TMO2018/1541-Diskettenlocher/Rev1_0/pic/1.jpg

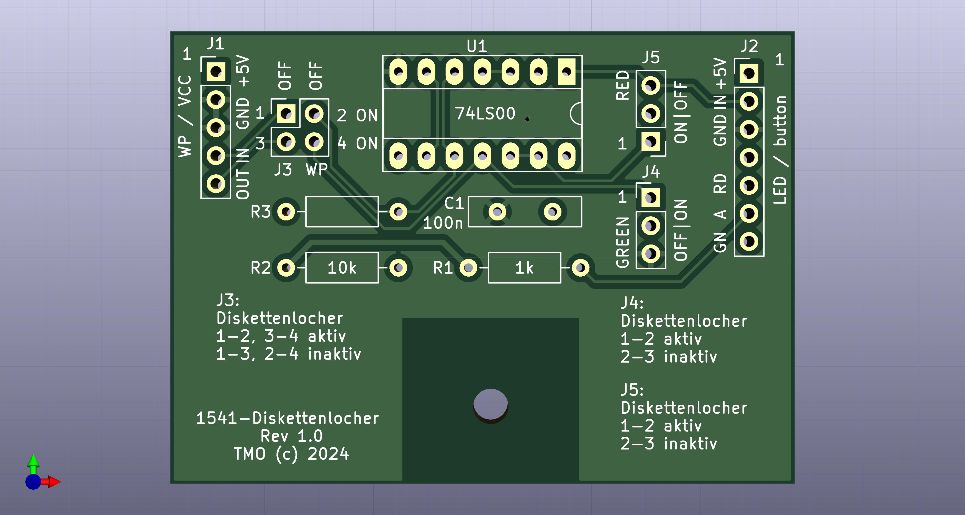
Rev1_0/pic/1.jpg
