TMO2018/1541-Diskettenlocher/Rev1_0/pic/IMG_0627.JPG

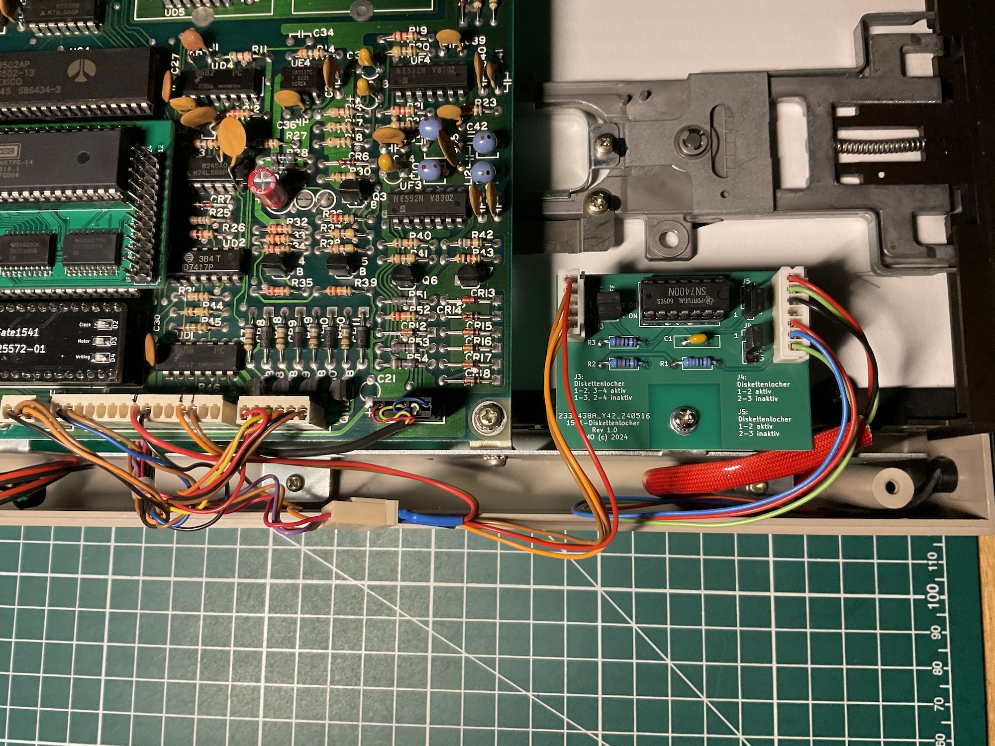
Rev1_0/pic/IMG_0627.JPG
