TMO2018/1541-Diskettenlocher/README.md

# 1541-Diskettenlocher
Elektronischer Diskettenlocher mit Touch-Sensor TTP223 für das Commodore-Diskettenlaufwerk VIC-1541
