TMO2018/1541-Diskettenlocher/Rev1_0/doc/DUO LED 5mm BiColor rot  grün diffus 3Pin gemeinsame Anode.pdf

Von: mail@tmonet.de
Betreff: DUO LED 5mm Bi-Color rot / grün diffus 3-Pin gemeinsame Anode Datum: 16. Mai 2024 um 15:38
An: Walter Thomas info.tom@t-online.de

Technische Daten:

Bauform: 5mm
Leuchtfarbe: rot und grün
Spannung: rot 2V DC / grün 3V DC Strom: 20mA
Abstrahlwinkel: 140°
Gehäusefarbe: weiß diffus

Gemeinsame Anode heißt: der mittlere längere Pin ist für + und die beiden äußeren sind -
