TMO2018/1541-Diskettenlocher/Rev1_0/pic/2.jpg

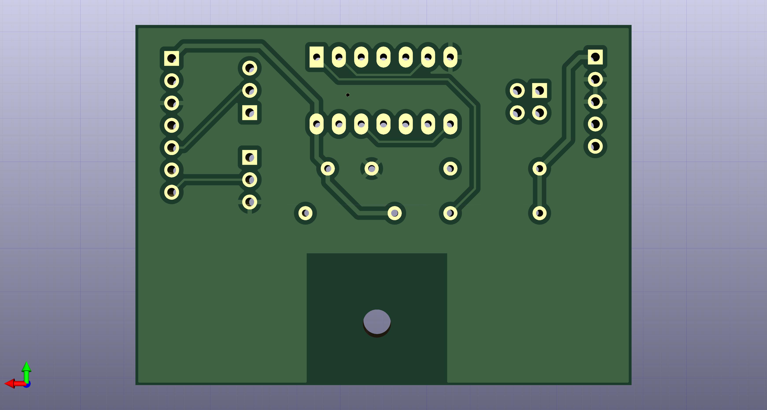
Rev1_0/pic/2.jpg
