TMO2018/1541-Diskettenlocher/Rev1_0/doc/1541_Diskettenlocher_schematic.pdf

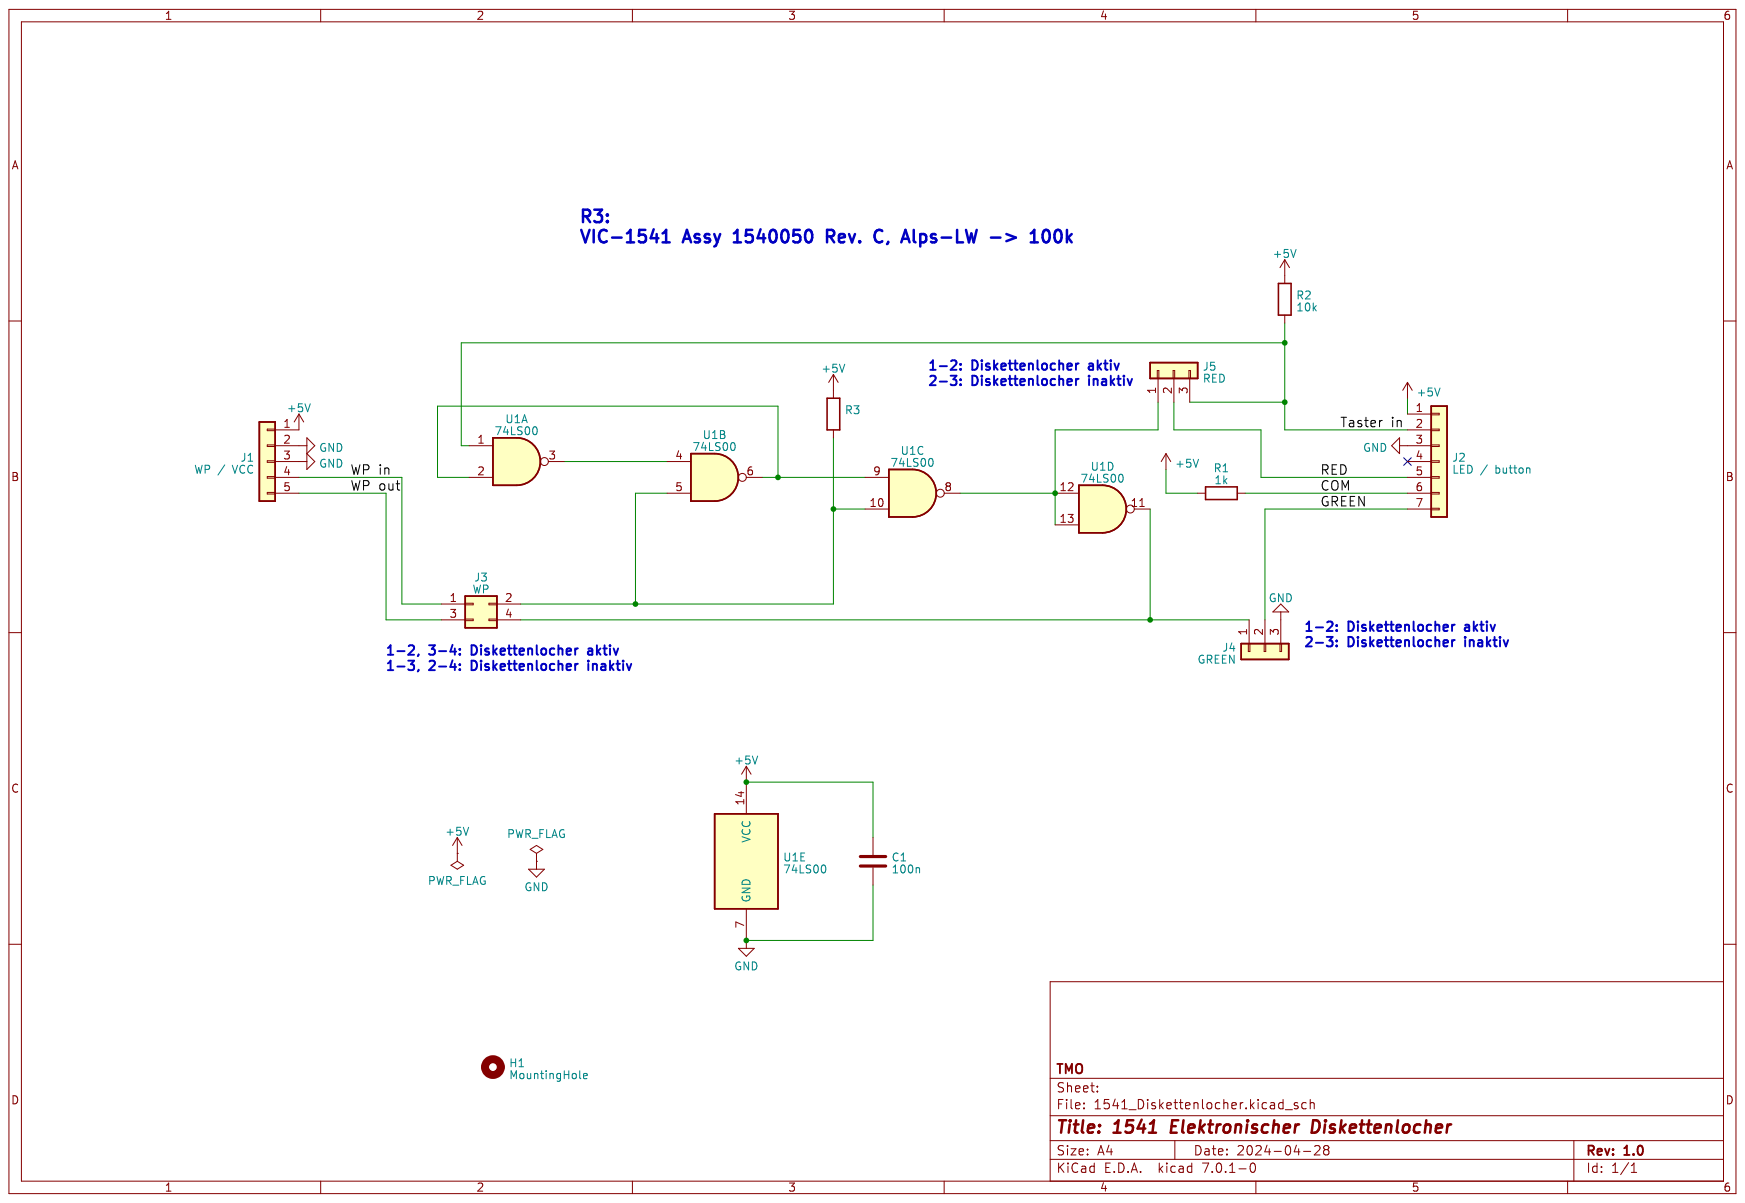
[picture p12: page 1]
