TMO2018/1541-Diskettenlocher/Rev1_0/1541_Diskettenlocher.kicad_pcb

## KiCad design Rev1_0/1541_Diskettenlocher.kicad_pcb (2024-06-19)

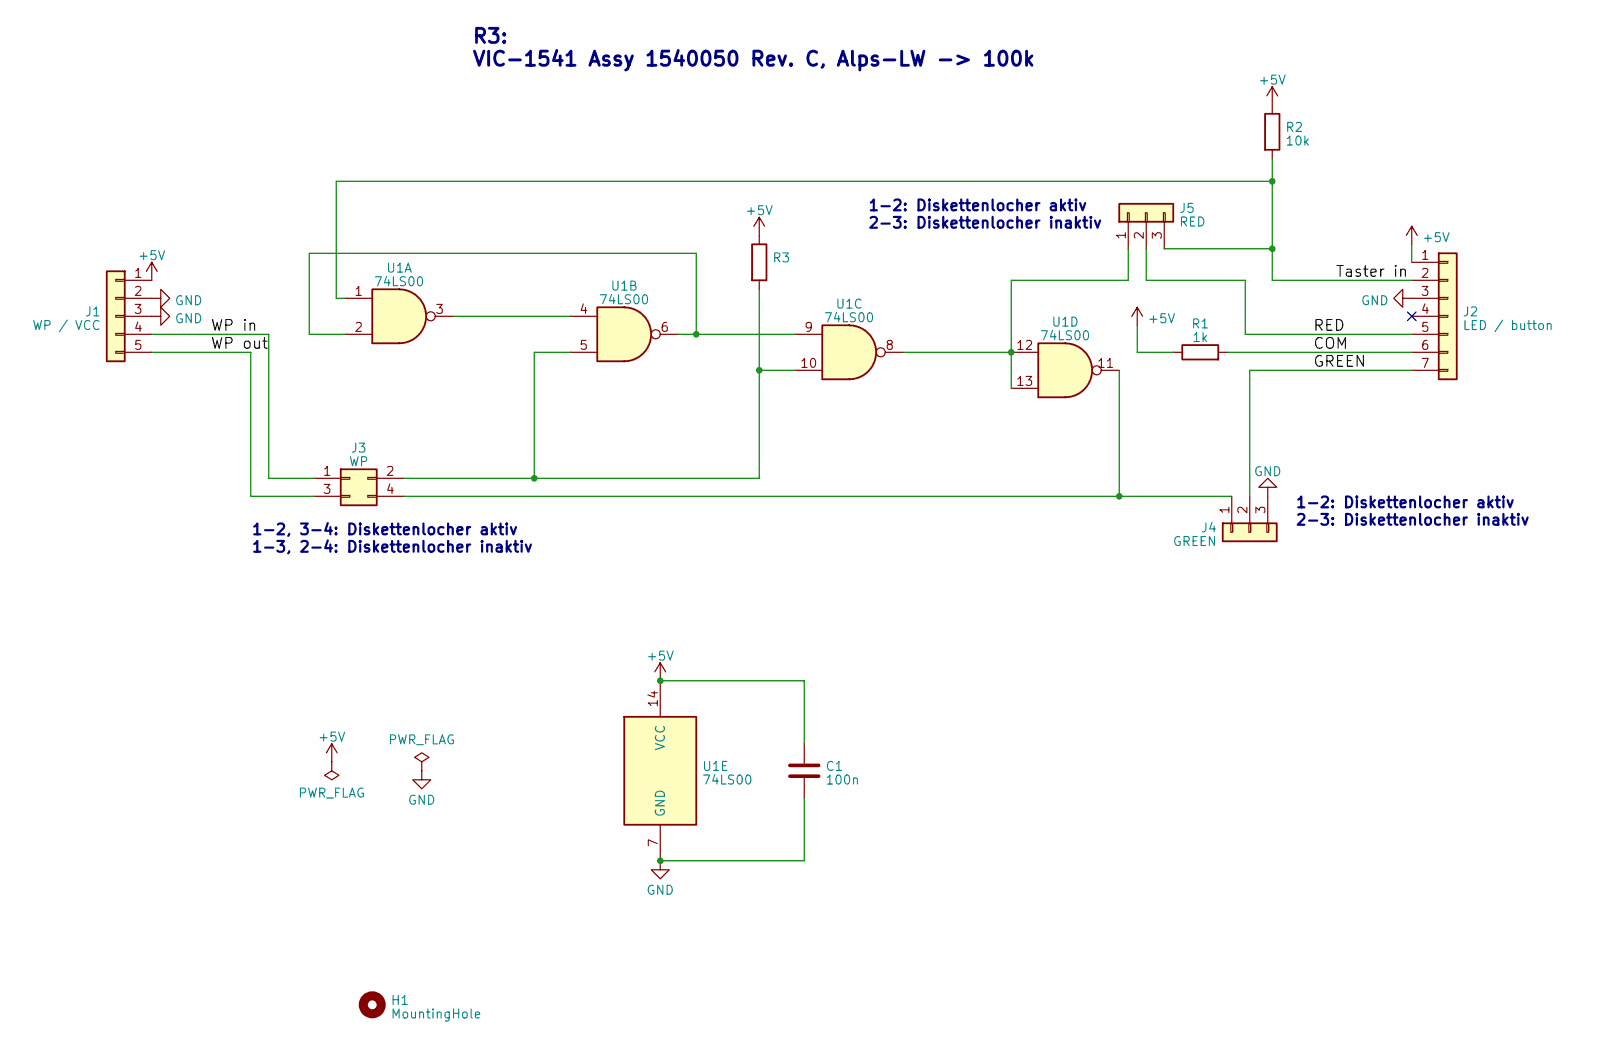
[picture p13: schematic 1541_Diskettenlocher.kicad_sch, 1541 Elektronischer Diskettenlocher]

Parts:
C1: 100n; C_Disc_D10.0mm_W2.5mm_P5.00mm
H1: MountingHole; MountingHole_3.2mm_M3
J1: WP / VCC; PinHeader_1x05_P2.54mm_Vertical
J2: LED / button; PinHeader_1x07_P2.54mm_Vertical
J3: WP; PinHeader_2x02_P2.54mm_Vertical
J4: GREEN; PinHeader_1x03_P2.54mm_Vertical
J5: RED; PinHeader_1x03_P2.54mm_Vertical
R1: 1k; R_Axial_DIN0207_L6.3mm_D2.5mm_P10.16mm_Horizontal
R2: 10k; R_Axial_DIN0207_L6.3mm_D2.5mm_P10.16mm_Horizontal
R3: R_Axial_DIN0207_L6.3mm_D2.5mm_P10.16mm_Horizontal
U1: 74LS00; DIP-14_W7.62mm_Socket_LongPads

Connections:
+5V: C1.1, J1.1, J2.1, R1.1, R2.1, R3.1, U1.14 (VCC)
/COM: J2.6, R1.2
/GREEN: J2.7, J4.2
/RED: J2.5, J5.2
/Taster in: J2.2, J5.3, R2.2, U1.1
/WP in: J1.4, J3.1
/WP out: J1.5, J3.3
GND: C1.2, J1.2, J1.3, J2.3, J4.3, U1.7 (GND)
unnamed: J3.2, R3.2, U1.5, U1.10
unnamed: J3.4, J4.1, U1.11
unnamed: J5.1, U1.8, U1.12, U1.13
unnamed: U1.2, U1.6, U1.9
unnamed: U1.3, U1.4

Notes on the sheet:
1-2: Diskettenlocher aktiv 2-3: Diskettenlocher inaktiv
R3: VIC-1541 Assy 1540050 Rev. C, Alps-LW -> 100k
1-2, 3-4: Diskettenlocher aktiv 1-3, 2-4: Diskettenlocher inaktiv

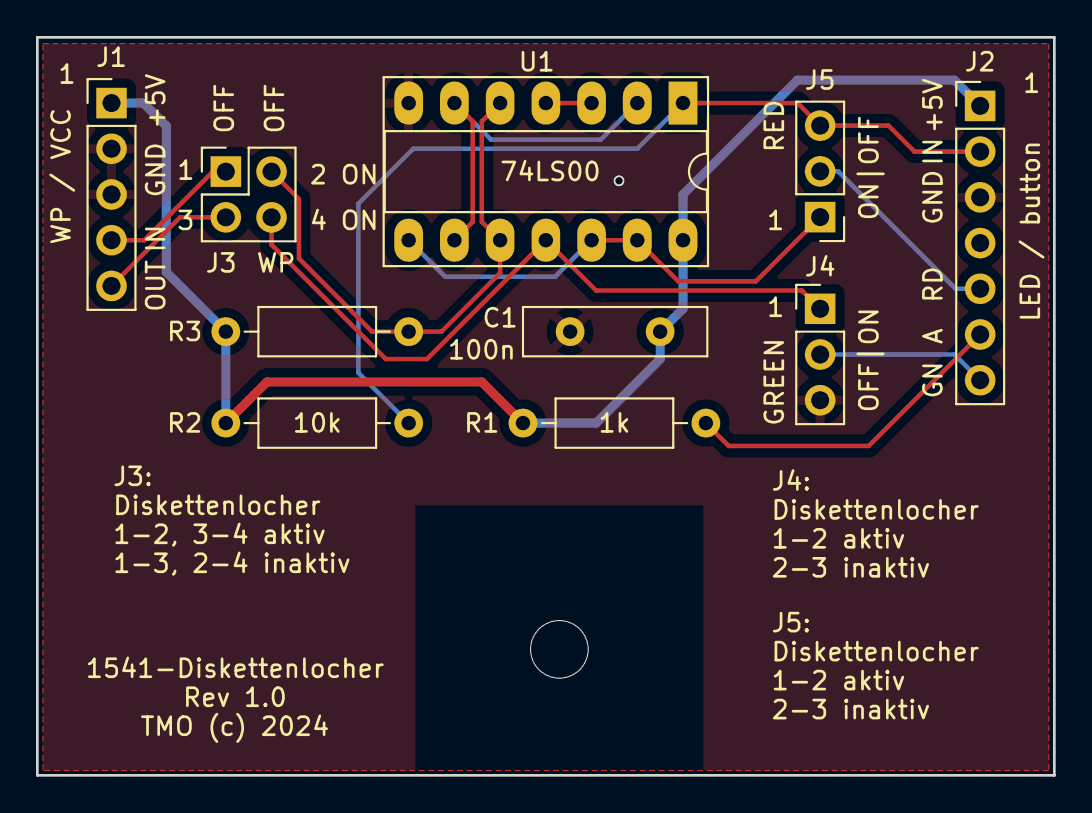
[picture p14: board 1541_Diskettenlocher.kicad_pcb from above]

Board: 2 copper layers, 56.5 x 41.0 mm, 11 parts (0 on the bottom side), 13 nets.
