TMO2018/1541-Diskettenlocher/(notices)

Notices in the files:
Rev1_0/1541_Diskettenlocher.kicad_pcb:
TMO (c) 2024
